MunteanLab/mouseduino/Electronics Assembly/Electronics Materials List.xlsx

Electronics |  |  |  | Total Cost | $283.36
Electronics Assembly Materials List
 | Quantity | Item | Unit Cost | Total Cost | Link
LEDs | 5 | Diffused RGB LED (Common Anode/10 mm/tri-color) | $0.99 | $4.97 | adafruit.com/product848
 | 5 | LED Holder (10mm) | $0.30 | $1.50 | https://www.adafruit.com/product/2171
Stepper Motor | 1 | NEMA 23 Stepper Motor | $27.99 | $27.99 | https://openbuildspartstore.com/nema-23-stepper-motor/?sku=518
 | 1 | Stepper Motor Driver | $9.99 | $9.99 | https://www.amazon.com/OUYZGIA-Stepper-Segments-Upgraded-Version-1PCS/dp/B08PKJG2ND?hvadid=616990817417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
Sensors | 5 | Sharp IR Range Sensor (GP2Y0A02YK0F/20 cm to 150 cm) | $10.45 | $52.25 | https://www.amazon.com/ELEGOO-ATmega2560-ATMEGA16U2-Projects-Compliant/dp/B01H4ZLZLQ?hvadid=570507306139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
Microcontrollers | 1 | Arduino Mega 2560 (ELEGOO compatible) | $20.99 | $20.99 | https://www.amazon.com/ELEGOO-ATmega2560-ATMEGA16U2-Projects-Compliant/dp/B01H4ZLZLQ
 | 1 | Arduino UNO (ELEGOO compatible) | $16.99 | $16.99 | https://www.amazon.com/ELEGOO-Board-ATmega328P-ATMEGA16U2-Compliant/dp/B01EWOE0UU
Buttons & Switches | 1 | Large Toggle Switch (20 amp) | $4.76 | $4.76 | https://www.homedepot.com/p/Gardner-Bender-20-Amp-Single-Pole-Toggle-Switch-1-Pack-GSW-121/100117400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
 | 1 | Small Toggle Switch (5 amp) | $1.59 | $1.59 | https://www.jameco.com/z/T100T1B1A1QN-Jameco-ValuePro-Mini-Toggle-Switch-SPST-ON-OFF-5A-125VAC_76523.html
 | 2 | White LED Pushbutton (24mm) | $2.50 | $5.00 | https://www.adafruit.com/product/3429
 | 1 | Red LED Pushbutton (24 mm) | $2.50 | $2.50 | https://www.adafruit.com/product/3430
LCD Panel | 1 | 20x4 Standard LCD Panel | $17.95 | $17.95 | https://www.adafruit.com/product/198
Power | 1 | 12V Power Supply | $12.20 | $12.20 | https://www.jameco.com/z/LRS-35-12-MEAN-WELL-36W-12V-3A-Single-Output-Enclosed-Power-Supply_2257475.html
 | 1 | 5V Power Supply | $9.12 | $9.12 | https://www.jameco.com/z/RS-15-5-MEAN-WELL-AC-to-DC-Power-Supply-5-Volt-3-Amp-15-Watt_1919043.html
 | 1 | Wall Plug | $6.42 | $6.42 | https://www.digikey.com/en/products/detail/qualtek/411006-01/13687867
 | 1 | Spade Connectors (Kit) | $0.03 | $0.03 | https://www.amazon.com/Nilight-Disconnect-Electrical-Solderless-Connectors/dp/B07V35375X
Bread Board | 2 | Half-Sized Breadboard PCB | $4.50 | $9.00 | https://www.adafruit.com/product/1609
 | 2 | 0.1 mF Tantalum Capacitors | 0.65 | $1.30 | https://www.digikey.com/en/products/detail/kyocera-avx/TAP104K050SCS/563935
 | 1 | Linear Potentiometer 10K | $2.43 | $2.43 | https://www.digikey.com/en/products/detail/bourns-inc/3296W-1-103LF/1088045
 | 3 | 1KΩ Through Hole Resistor (1/4 Watt) | $0.10 | $0.30 | https://www.digikey.com/en/products/detail/stackpole-electronics-inc/CF14JT1K00/1741314
 | 15 | 220 Ω Through Hole Resistoer (1/4 Watt, Carbon Film) | $0.10 | $1.50 | https://www.digikey.com/en/products/detail/yageo/CFR-25JB-52-220R/1295
Wiring | 1 | 24 Gauge Stranded Wires (Kit) | $11.95 | $11.95 | https://www.amazon.com/Fermerry-Stranded-Electrical-Silicone-Cables/dp/B089CRSLG8?hvadid=459709171878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
 | 1 | 24 Gauge Solid Core Wire (Kit) | $15.95 | $15.95 | https://www.digikey.com/en/products/detail/adafruit-industries-llc/1311/6198255
 | 1 | Custom Made Dupont Cable (Kit) | $9.99 | $9.99 | https://www.amazon.com/Dupont-Connector-Kit-Connectors-Plusivo/dp/B078RRPRQZ?hvadid=241994846339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
 | 1 | Female/Male Header Row (Pack of 5) | $2.95 | $2.95 | https://www.adafruit.com/product/598
 | 9 | 3 Input Terminal Blocks (5.08 mm) | $1.22 | $10.98 | https://www.digikey.com/en/products/detail/on-shore-technology-inc/EDZ500-3DS/250583
 | 3 | 2 Input Verticle Terminal Block (5.08 mm) | $1.98 | $5.94 | https://www.digikey.com/en/products/detail/phoenix-contact/1868128/2511083
 | 2 | 2 Input Side Terminal Blocks (2.54 mm) | $1.95 | $3.90 | https://www.digikey.com/en/products/detail/te-connectivity-amp-connectors/282834-2/1150135
Other | 1 | 12VDC Sunon Maglev Cooling Fan (ME60151V1-000U-A99) | $9.06 | $9.06 | Ebay Purchase
 | 1 | Mini Zip Ties (Pack) | $3.85 | $3.85 | https://www.amazon.com/Bates-Zip-Ties-4-inch/dp/B08P2HKSVM?hvadid=533377409716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
Used Tools and Materials
Tool Kit |  | Soldering Board |  | $0.00
 |  | Wire Stripper |  | $0.00
 |  | Wire Cutter |  | $0.00
 |  | Solder |  | $0.00
 | 1 | Shrink Tube (Kit) | $19.95 | $19.95 | https://www.jameco.com/z/HSTBOX160-Jameco-ValuePro-158-Piece-4-Inch-Polyolefin-Heat-Shrink-Tubing-Kit-Assorted-Colors-and-Diameters_2095947.html
 |  | Heat Gun |  | $0.00
 |  |  |  | $0.00
