MunteanLab/mouseduino/Rod Assembly/Rod Assembly Material Info.xlsx

Base Assembly Parts |  |  |  | Total Cost | 75.62
 | Quantity | Item | Unit Cost | Cost | Link
Rod Assembly | 2 | 5/16 Bolt (5 inch) | 0.69 | 1.38 | https://www.homedepot.com/p/Everbilt-5-16-in-18-x-5-in-Zinc-Plated-Hex-Bolt-800796/204645557
 | 6 | 5/16 Nuts | 0.46 | 2.76 | https://www.homedepot.com/p/Everbilt-5-16-in-18-Stainless-Steel-Hex-Nut-3-Pack-800061/204746982
 | 2 | 5/16 Winged Nut | 0.99 | 1.98 | https://www.homedepot.com/p/Everbilt-5-16-in-18-Stainless-Wing-Nuts-15-Pack-38962/203436320
 | 2 | Ball Bearing | 0.5 | 1 | https://www.amazon.com/%EF%BC%BB10-Pack%EF%BC%BD-608-Ball-Bearings/dp/B08XVFSZTF?hvadid=564681743706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
 | 4 | M5 Nut | 0.625 | 2.5 | https://www.homedepot.com/p/M5-0-8-x-25-mm-Class-8-8-Zinc-Plated-Hex-Bolt-2-Pack-801378/204273538
 | 4 | M5 Bolt | 0.625 | 2.5 | https://www.homedepot.com/p/5-mm-0-8-Stainless-Steel-Metric-Hex-Nut-2-per-Pack-801008/204274112
 | 1 | Black Acrylic (18x18inch) | 63.5 | 63.5 | https://www.homedepot.com/p/Falken-Design-36-in-x-36-in-x-1-8-in-Thick-Acrylic-Black-Opaque-Sheet-Falken-Design-ACRYLIC-BK-1-8-3636/308669330
