MunteanLab/mouseduino/Base Assembly/Base Assembly Materials Info.xlsx

Base Assembly Parts |  |  |  | Total Cost | 167.754
 | Quantity | Item | Unit Cost | Cost | Link
Base Assembly | 1 | Clear Acrylic (36x36 inch) | 43.88 | 43.88 | https://outlook.office.com/mail/safelink.html?corid=cd0257e4-9334-0e3d-4781-f777b9cd1fdf
 | 1 | Black Acrylic (24x72 inch) | 73.51 | 73.51 | https://outlook.office.com/mail/safelink.html?corid=f630b29c-1ba0-c5cf-dc35-a7b99e10a33a
 | 3 | Loctite Superglue | 4.27 | 12.81 | https://www.amazon.com/Loctite-Control-4-Gram-Bottle-1739050/dp/B00ELV2D0Y?asc_contenttype=article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
 | 4 | M2 Bolts (LCD) | 0.025 | 0.1 | https://www.amazon.com/HanTof-Threaded-Machine-Assortment-Wrench%EF%BC%8CBlack/dp/B09D8ZZ9YM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
 | 4 | M2 Nuts | 0.025 | 0.1 | https://www.amazon.com/HanTof-Threaded-Machine-Assortment-Wrench%EF%BC%8CBlack/dp/B09D8ZZ9YM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
 | 4 | M5 Bolts 40 mm (Stepper Motor) | 1.375 | 5.5 | https://www.homedepot.com/p/Everbilt-M5-0-8-x-40-mm-Phillips-Pan-Head-Stainless-Steel-Machine-Screw-2-Pack-843098/204283788
 | 8 | M5 Nuts | 0.625 | 5 | https://www.homedepot.com/p/5-mm-0-8-Stainless-Steel-Metric-Hex-Nut-2-per-Pack-801008/204274112
 | 4 | M5 Bolt 50 mm (Fan) | 1.375 | 5.5 | https://www.homedepot.com/p/Everbilt-M5-0-8-x-50-mm-Phillips-Pan-Head-Stainless-Steel-Machine-Screw-2-Pack-843118/204283790
 | 12 | (Hinges) #6-32 x 3/14 inch Flat Phillips and Nuts | 0.267 | 3.204 | https://www.homedepot.com/p/Hillman-6-32-x-3-4-in-Phillips-Flat-Head-Machine-Screws-25-Pack-4058/204795038
 | 1 | Acrylic Clasps | 8.99 | 8.99 | https://www.amazon.com/gp/product/B0814QLSJF/ref=ppx_yo_dt_b_asin_title_o01_s00?ie=UTF8&psc=1
 | 20 | Mini Wheels | 0.458 | 9.16 | https://www.amazon.com/gp/product/B08ZHGW6TX/ref=ppx_yo_dt_b_asin_title_o01_s00?ie=UTF8&psc=1
