MunteanLab/mouseduino/Base Assembly/Laser Cutting Files/Part L. Rod Barriers.dxf

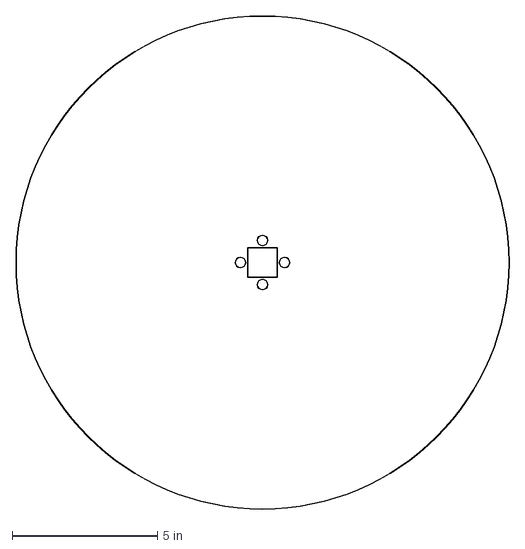
[picture p1: CAD file, 2023-02-23]
Base Assembly/Laser Cutting Files/Part L. Rod Barriers.dxf
17.0 x 17.0 in
