MunteanLab/mouseduino/Capture Boxes/Laser Cut Files/Part C. Front (5x).dxf

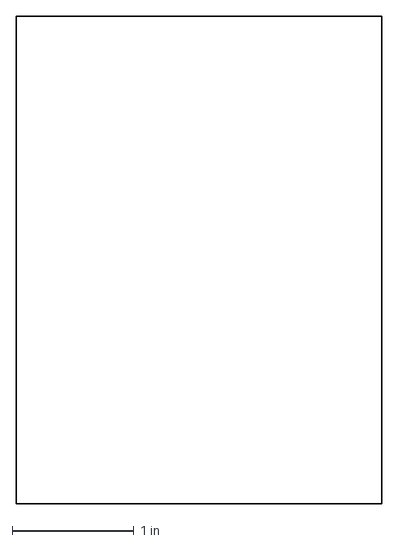
[picture p2: CAD file, 2023-04-18]
Capture Boxes/Laser Cut Files/Part C. Front (5x).dxf
3.00 x 4.00 in
