MunteanLab/mouseduino/Base Assembly/Laser Cutting Files/Part C. Front Top.dxf

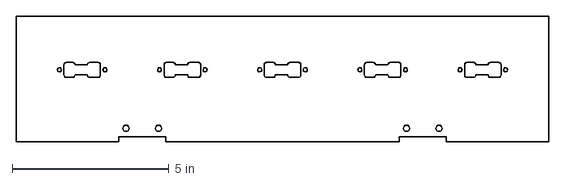
[picture p3: CAD file, 2023-02-23]
Base Assembly/Laser Cutting Files/Part C. Front Top.dxf
17.0 x 4.00 in
