MunteanLab/mouseduino/Capture Boxes/Laser Cut Files/Part B. Sides (10x).dxf

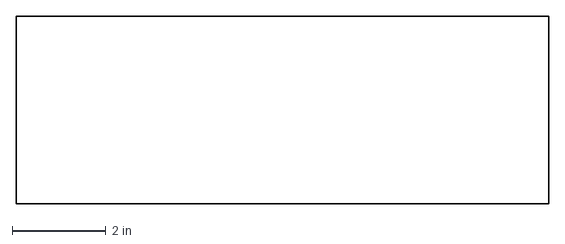
[picture p4: CAD file, 2023-04-18]
Capture Boxes/Laser Cut Files/Part B. Sides (10x).dxf
11.4 x 4.00 in
