MunteanLab/mouseduino/Base Assembly/Laser Cutting Files/Part B. Front Bottom.dxf

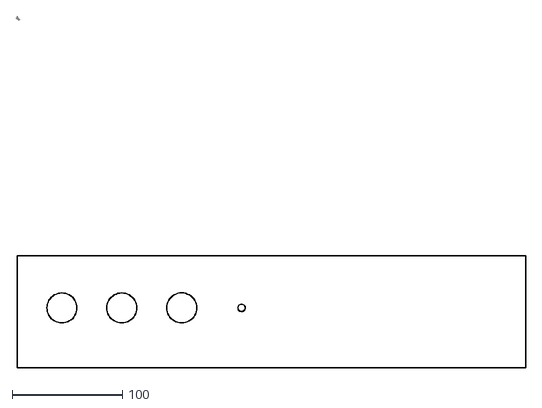
[picture p5: CAD file, 2023-02-23]
Base Assembly/Laser Cutting Files/Part B. Front Bottom.dxf
461.4 x 318.2
