MunteanLab/mouseduino/Capture Boxes/Laser Cut Files/Part D. Tracks.dxf

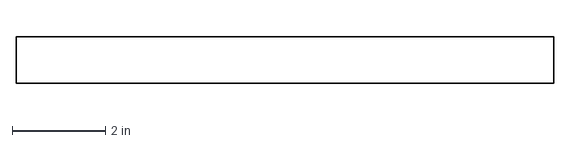
[picture p6: CAD file, 2023-04-18]
Capture Boxes/Laser Cut Files/Part D. Tracks.dxf
11.5 x 1 in
