MunteanLab/mouseduino/Base Assembly/Laser Cutting Files/Part E. Lid Top.dxf

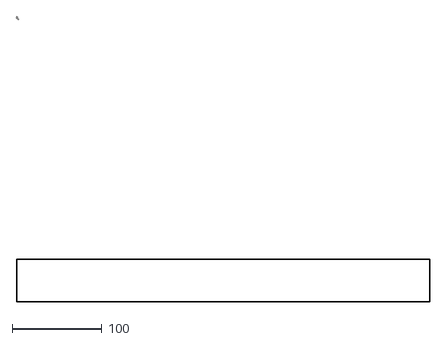
[picture p7: CAD file, 2023-02-23]
Base Assembly/Laser Cutting Files/Part E. Lid Top.dxf
461.4 x 318.2
