MunteanLab/mouseduino/Capture Boxes/Laser Cut Files/Part A. Base (5x).dxf

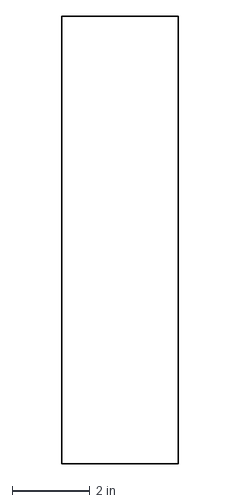
[picture p8: CAD file, 2023-04-18]
Capture Boxes/Laser Cut Files/Part A. Base (5x).dxf
3.00 x 11.5 in
