MunteanLab/mouseduino/Base Assembly/Laser Cutting Files/Part D. Left Side -motor updated.dxf

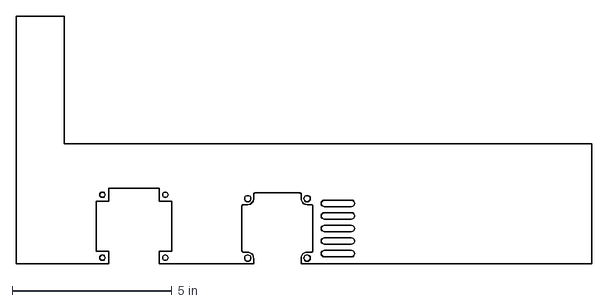
[picture p9: CAD file, 2023-02-23]
Base Assembly/Laser Cutting Files/Part D. Left Side -motor updated.dxf
18.0 x 7.75 in
