MunteanLab/mouseduino/Base Assembly/Laser Cutting Files/Part H. Right Side Rod Support.dxf

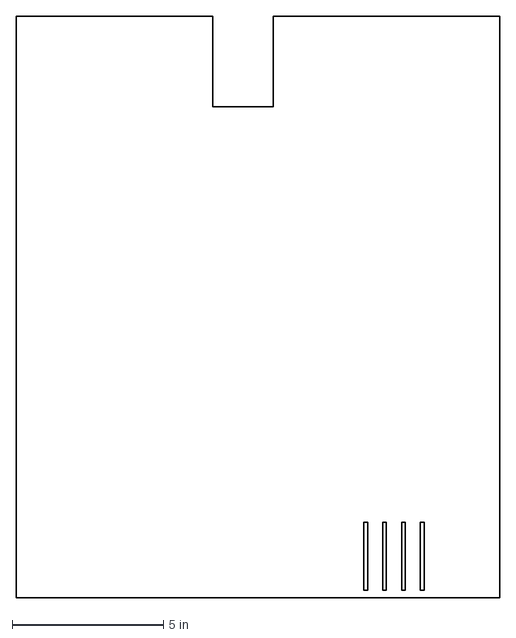
[picture p10: CAD file, 2023-02-03]
Base Assembly/Laser Cutting Files/Part H. Right Side Rod Support.dxf
16.0 x 19.2 in
