MunteanLab/mouseduino/Base Assembly/Laser Cutting Files/Part G. Right Side.dxf

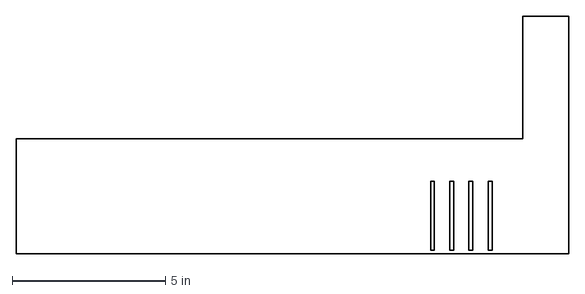
[picture p11: CAD file, 2023-02-03]
Base Assembly/Laser Cutting Files/Part G. Right Side.dxf
18.0 x 7.75 in
