MunteanLab/mouseduino/Base Assembly/Laser Cutting Files/Part F2. Lid Part B Updated.dxf

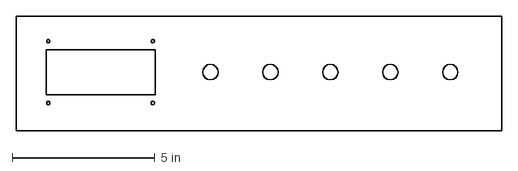
[picture p12: CAD file, 2023-02-03]
Base Assembly/Laser Cutting Files/Part F2. Lid Part B Updated.dxf
17.0 x 4.00 in
