MunteanLab/mouseduino/Base Assembly/Laser Cutting Files/Part K. Back Cover Hinge Redesign.dxf

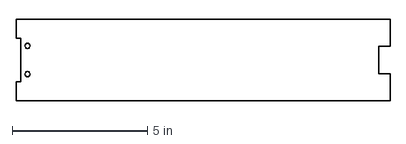
[picture p13: CAD file, 2023-02-03]
Base Assembly/Laser Cutting Files/Part K. Back Cover Hinge Redesign.dxf
13.8 x 3.00 in
