MunteanLab/mouseduino/Base Assembly/Laser Cutting Files/Part F1. Lid Hinge Redesign.dxf

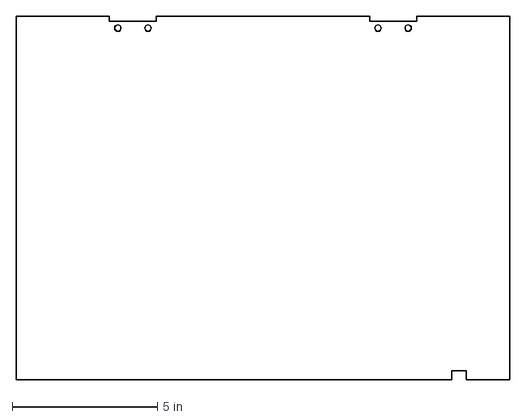
[picture p14: CAD file, 2023-02-03]
Base Assembly/Laser Cutting Files/Part F1. Lid Hinge Redesign.dxf
17.0 x 12.5 in
