MunteanLab/mouseduino/Base Assembly/Laser Cutting Files/Part C. Front Top Hinge Redesign.dxf

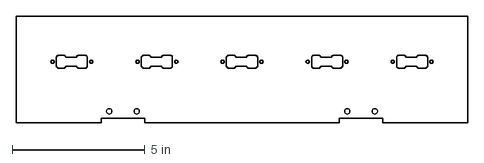
[picture p15: CAD file, 2023-02-03]
Base Assembly/Laser Cutting Files/Part C. Front Top Hinge Redesign.dxf
17.0 x 4.00 in
