MunteanLab/mouseduino/Base Assembly/Laser Cutting Files/Part J. Back Piece Hinge Redesign.dxf

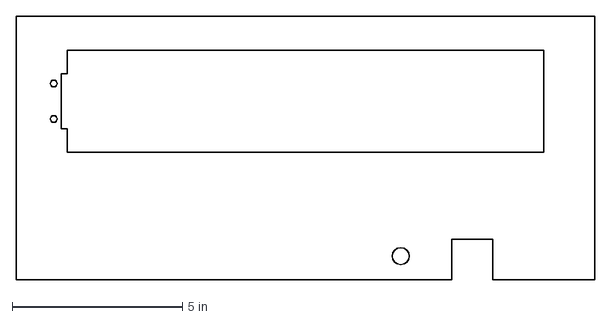
[picture p16: CAD file, 2023-02-03]
Base Assembly/Laser Cutting Files/Part J. Back Piece Hinge Redesign.dxf
17.0 x 7.75 in
