MunteanLab/mouseduino/Base Assembly/Laser Cutting Files/Part A. Bottom Piece.dxf

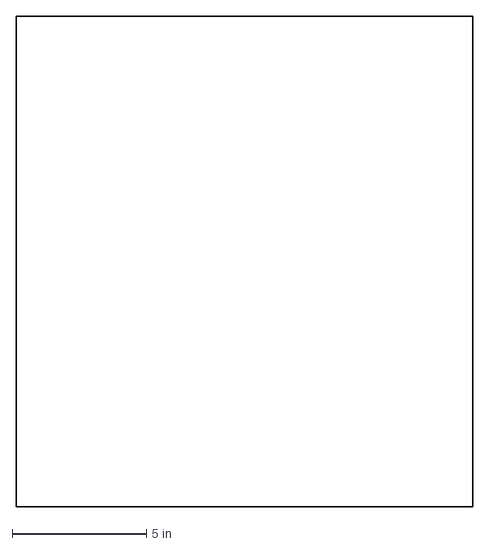
[picture p17: CAD file, 2023-02-03]
Base Assembly/Laser Cutting Files/Part A. Bottom Piece.dxf
17.0 x 18.2 in
