MunteanLab/mouseduino/Base Assembly/Laser Cutting Files/Part I. Left Side Rod Support.dxf

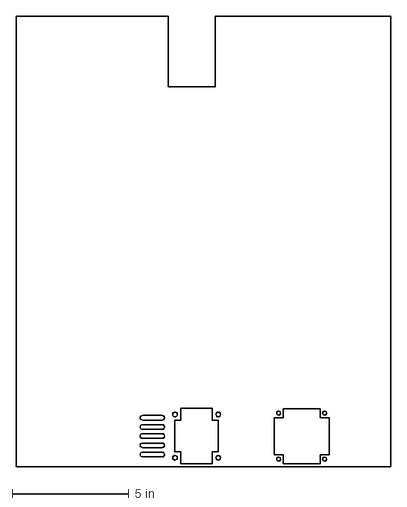
[picture p18: CAD file, 2023-02-03]
Base Assembly/Laser Cutting Files/Part I. Left Side Rod Support.dxf
16.0 x 19.2 in
