MunteanLab/mouseduino/(list of files, cad)

Other CAD files:
Base Assembly/Inventor Files/220207 Part A. Bottom Piece.ipt
Base Assembly/Inventor Files/220207 Part B. Front Bottom.ipt
Base Assembly/Inventor Files/220207 Part C. Front Top.ipt
Base Assembly/Inventor Files/220207 Part E. Lid Top.ipt
Base Assembly/Inventor Files/220207 Part F1. Lid Part A.ipt
Base Assembly/Inventor Files/220207 Part G. Right Side.ipt
Base Assembly/Inventor Files/220228 Part D. Left Side.ipt
Base Assembly/Inventor Files/220228 Part J. Back Piece.ipt
Base Assembly/Inventor Files/220307 Part F2. Lid Part B.ipt
Base Assembly/Inventor Files/220310 Part H. Right side Supports.ipt
Base Assembly/Inventor Files/220310 Part I. Left Side Rod Support.ipt
Base Assembly/Inventor Files/220310 Part K. Back Cover.ipt
Capture Boxes/Inventor Files/Part A. Base.ipt
Capture Boxes/Inventor Files/Part B. Sides X2.ipt
Capture Boxes/Inventor Files/Part C. Front.ipt
Capture Boxes/Inventor Files/Part D. Tracks.ipt
Rod Assembly/Inventor Files/220104 Center Piece.ipt
Rod Assembly/Inventor Files/220104 Left Side Piece Corrected 0.02 inch.ipt
Rod Assembly/Inventor Files/220108 End Piece Corrected 0.02 Inch.ipt
Rod Assembly/Inventor Files/220108 Right Side PIece Corrected 0.02 inch.ipt
Rod Assembly/Inventor Files/220122 Rod Dividers.ipt
Rod Assembly/Inventor Files/220411 Large Rod Laddered.ipt
Rod Assembly/Inventor Files/220411 Large Rod Plain.ipt
Rod Assembly/Inventor Files/220411 Small Rod Laddered.ipt
Rod Assembly/Inventor Files/220411 Small Rod Plain.ipt
Rod Assembly/Inventor Files/220425 End Cap.ipt
Rod Assembly/Inventor Files/220525 Large Rod Notched.ipt
Rod Assembly/Inventor Files/220525 Notch 0.5 inch.ipt
Rod Assembly/Inventor Files/230307 Bottom Pulley Adjusted.ipt
Rod Assembly/Inventor Files/Bearing Holder Part A.ipt
Rod Assembly/Inventor Files/Bearing Holder Part B.ipt
Rod Assembly/Inventor Files/Top Pulley.ipt
