MunteanLab/mouseduino/Rod Assembly/Rod Attachment Dimensions.pdf

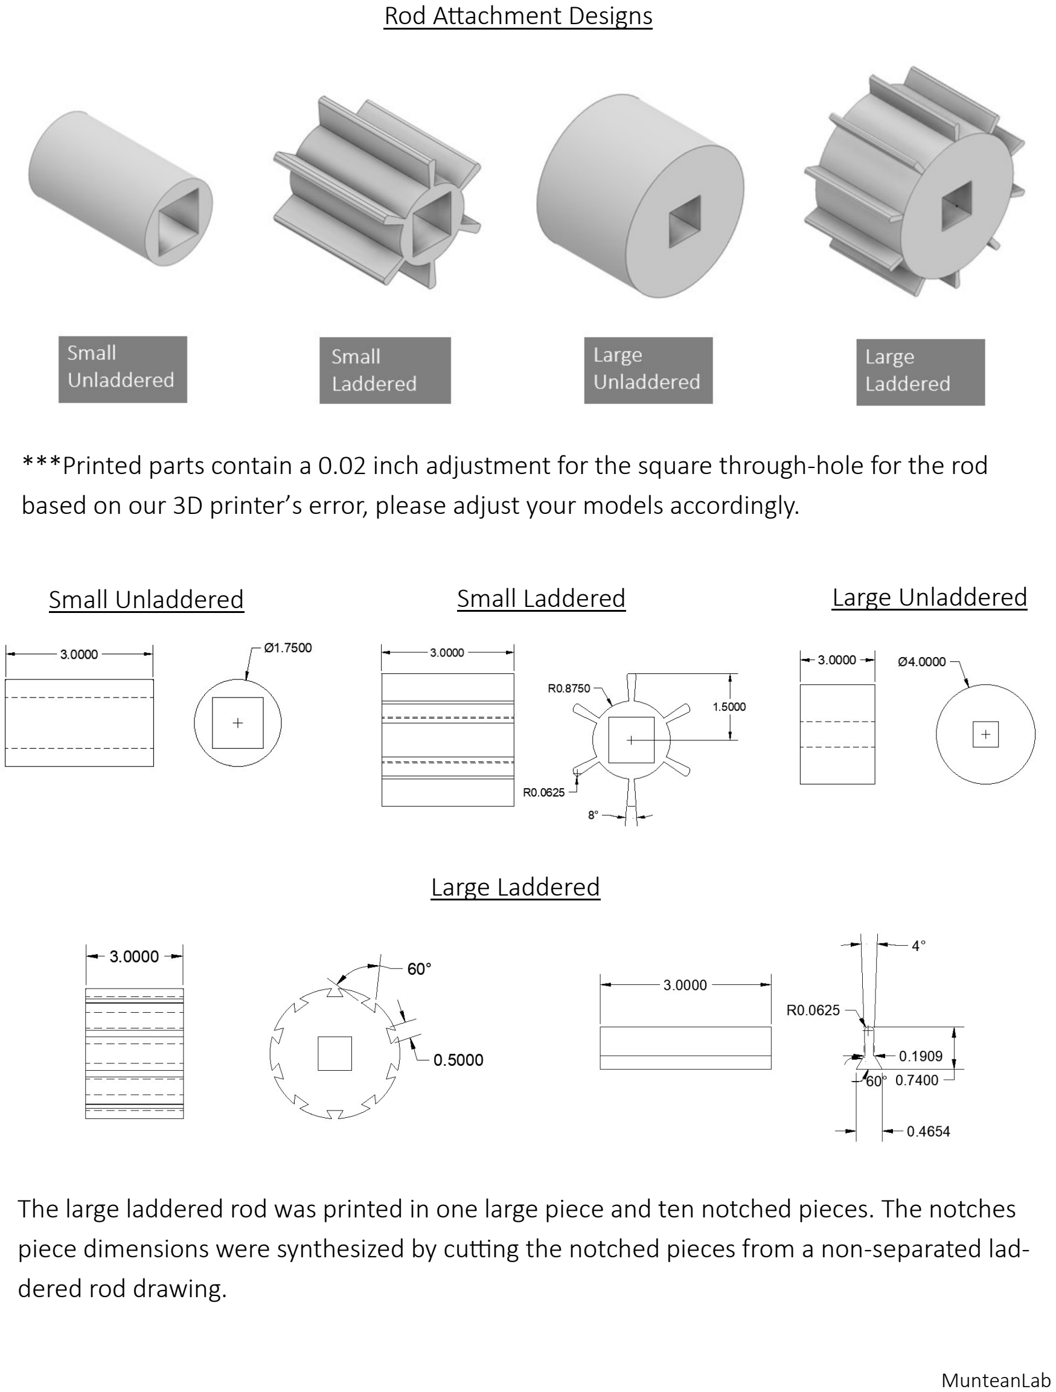
[picture p19: page 1]

Rod Aachment Designs

MunteanLab

***Printed parts contain a 0.02 inch adjustment for the square through-hole for the rod based on our 3D printer’s error, please adjust your models accordingly.

Small Unladdered | Small Laddered | Large Unladdered

Large Laddered

The large laddered rod was printed in one large piece and ten notched pieces. The notches piece dimensions were synthesized by cung the notched pieces from a non-separated laddered rod drawing.
