MunteanLab/mouseduino/Base Assembly/Base Assembly Guide.pdf

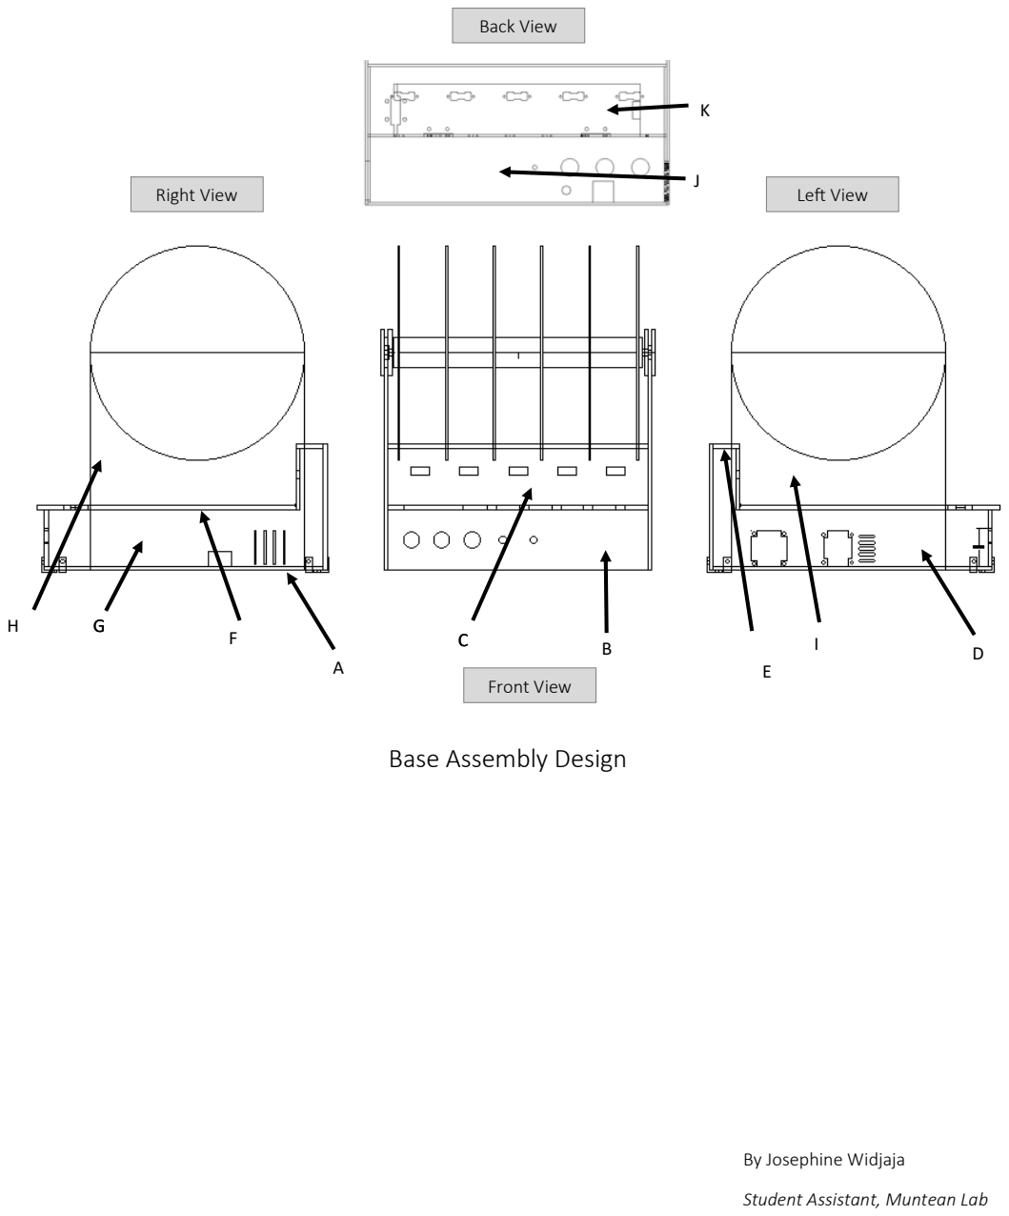
[picture p20: page 1]

G
F
A

C
B | I
D

## Base Assembly Design

By Josephine Widjaja

Student Assistant, Muntean Lab

Back View

Right View | Left View

Front View

H

E

J

K

PAGE 1—Table of Contents

PAGE 2

A. Base Bottom
B. Front Bottom
C. Front Top
D. Left Piece
E. Top Piece

F1. Lid Top Part A

PAGE 3

F2. Lid Top Part B

G. Right Piece
H. Right Side Support
I. Left Side Support
J. Back Piece
K. Back Cover

PAGE 4

L. Rod Barrier (X6 Required, 2 clear and 4 opaque)

Acrylic Sheet Dimensioning—We had to cut the acrylic sheets down to fit inside the laser cutter. Here you can see how we cut the pieces to accommodate for the size of our laser cutter and our sheets of acrylic.

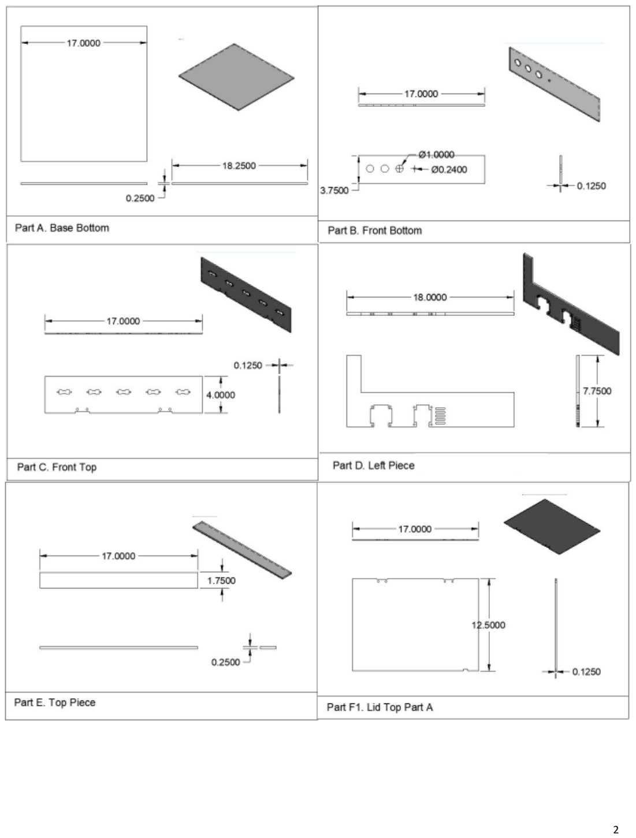
[picture p21: page 3]
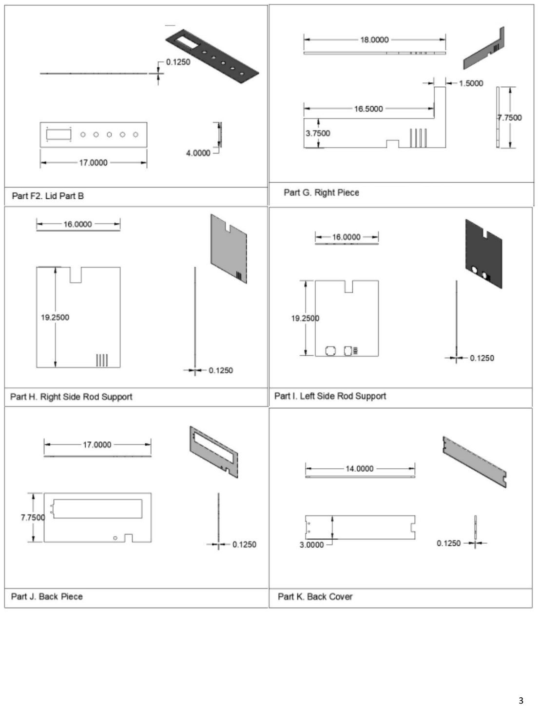
[picture p22: page 4]
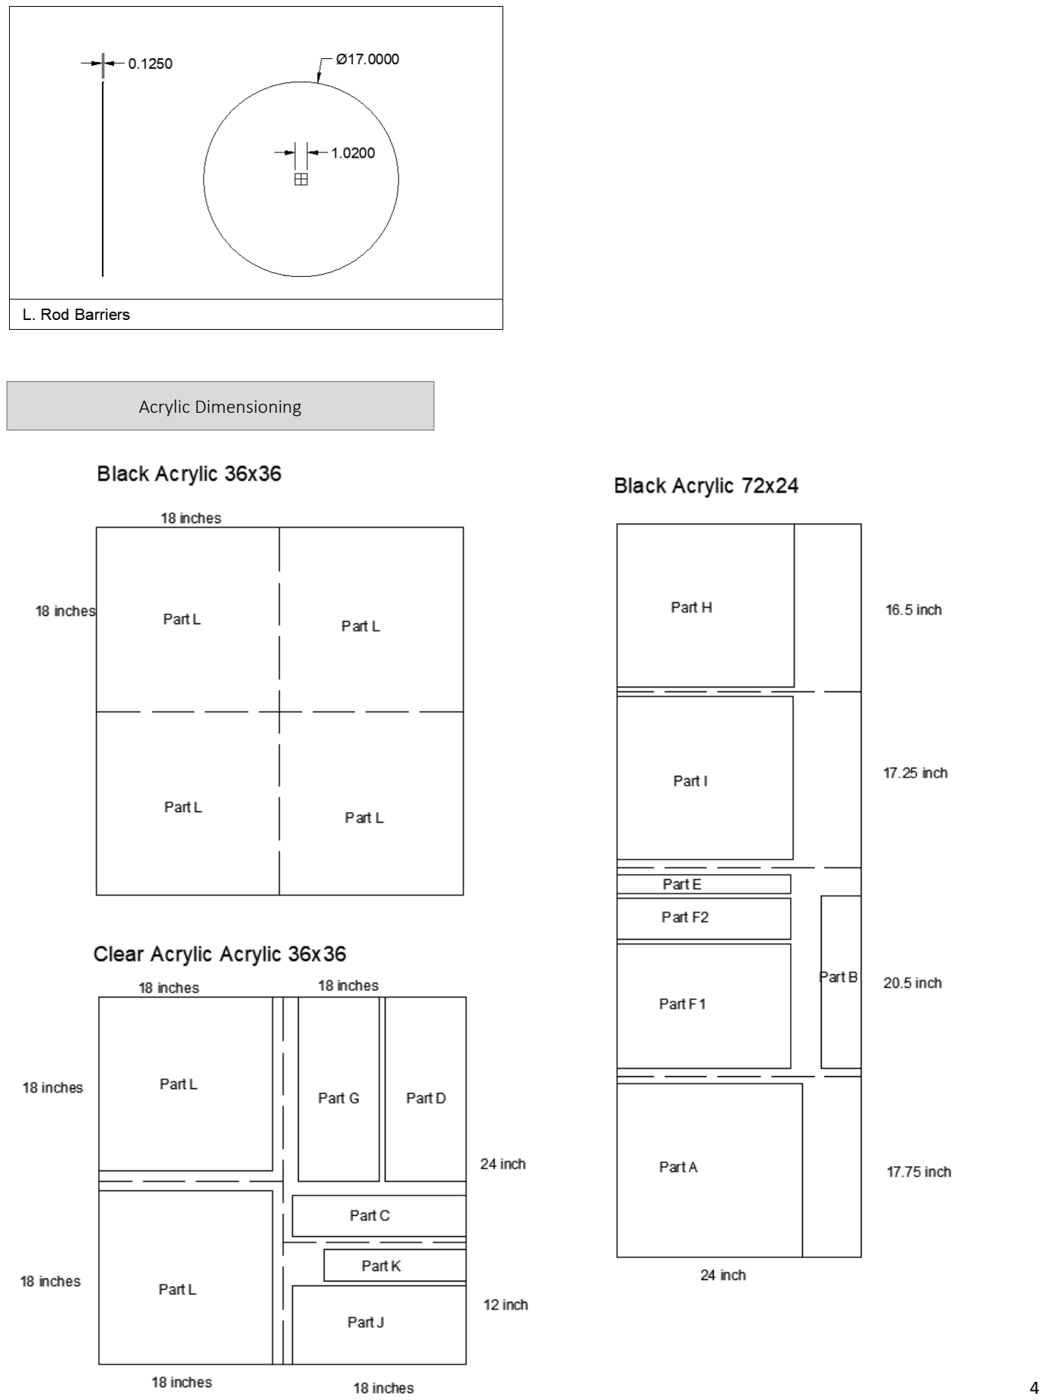
[picture p23: page 5]

Acrylic Dimensioning
