MunteanLab/mouseduino/Capture Boxes/Capture Box Assembly Guide.pdf

## MOUSEDUINO CAPTURE BOX DESIGN (1/8th inch acrylic sheets)

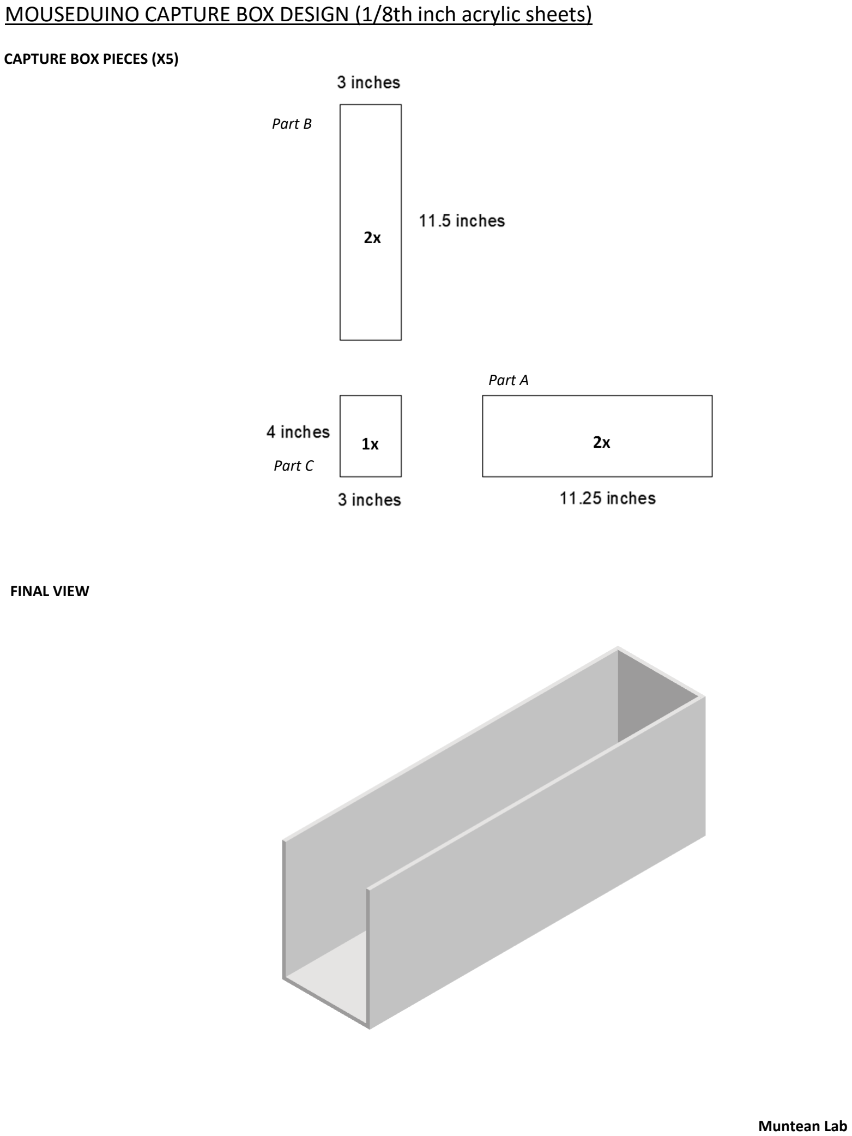
[picture p24: page 1]

CAPTURE BOX PIECES (X5)

FINAL VIEW

Part B

Part C

Part A

Muntean Lab

## MOUSEDUINO CAPTURE BOX DESIGN (1/8th inch acrylic sheets)

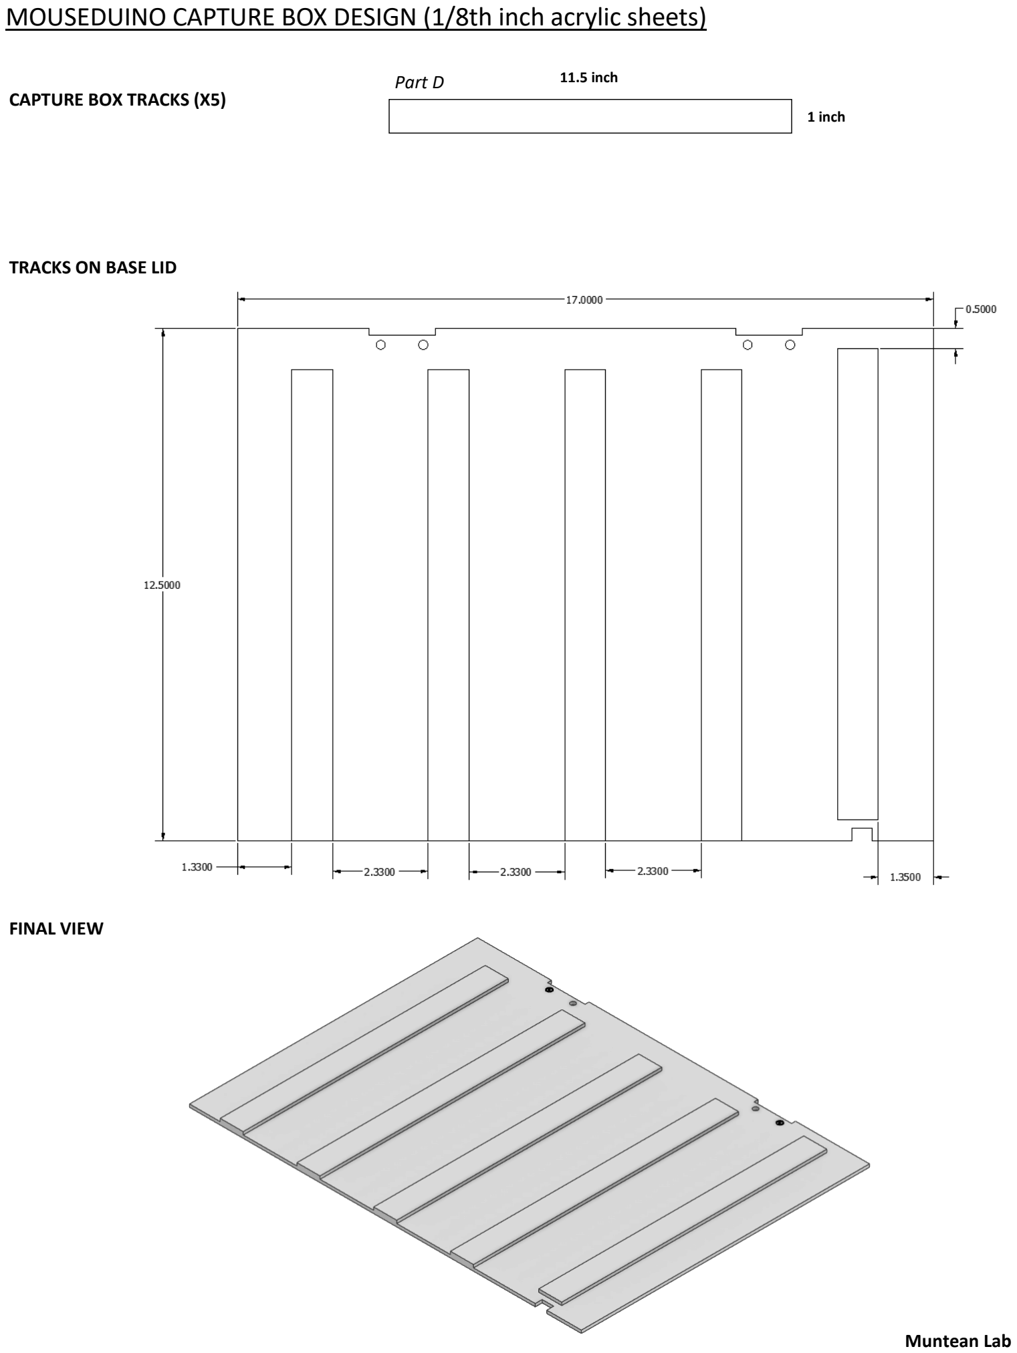
[picture p25: page 2]

CAPTURE BOX TRACKS (X5)

### 11.5 inch

### 1 inch

TRACKS ON BASE LID

FINAL VIEW

Part D

Muntean Lab
